conradspiteri-alt/vetus-ec4-decode/hardware/sniffer/enclosure/EC4-Enclosure-Drawing.pdf

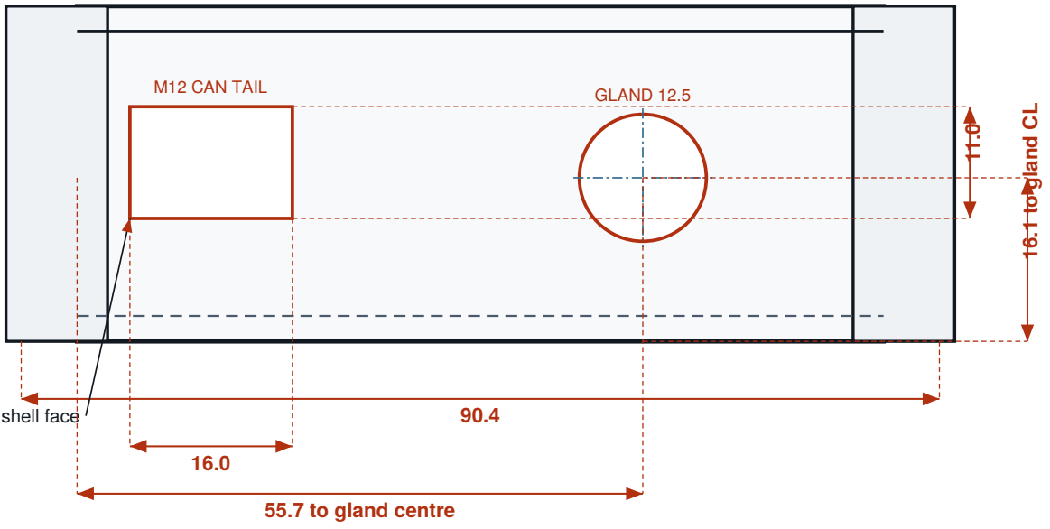
[picture p15: figure]
M12 CAN TAIL; GLAND 12.5; 55.7 to gland centre; 16.1 to gland CL

## EC4 SNIFFER - ENCLOSURE rev B

DWG EC4-200 rev B | NTS | UNITS mm
MATERIAL 3D printed ASA | | WALL / FLOOR / LID 2.5
END VIEW from the connector face | FIXINGS 4 off M3 heat-set insert
DATUM lower-left-front corner | | SEALING none this iteration

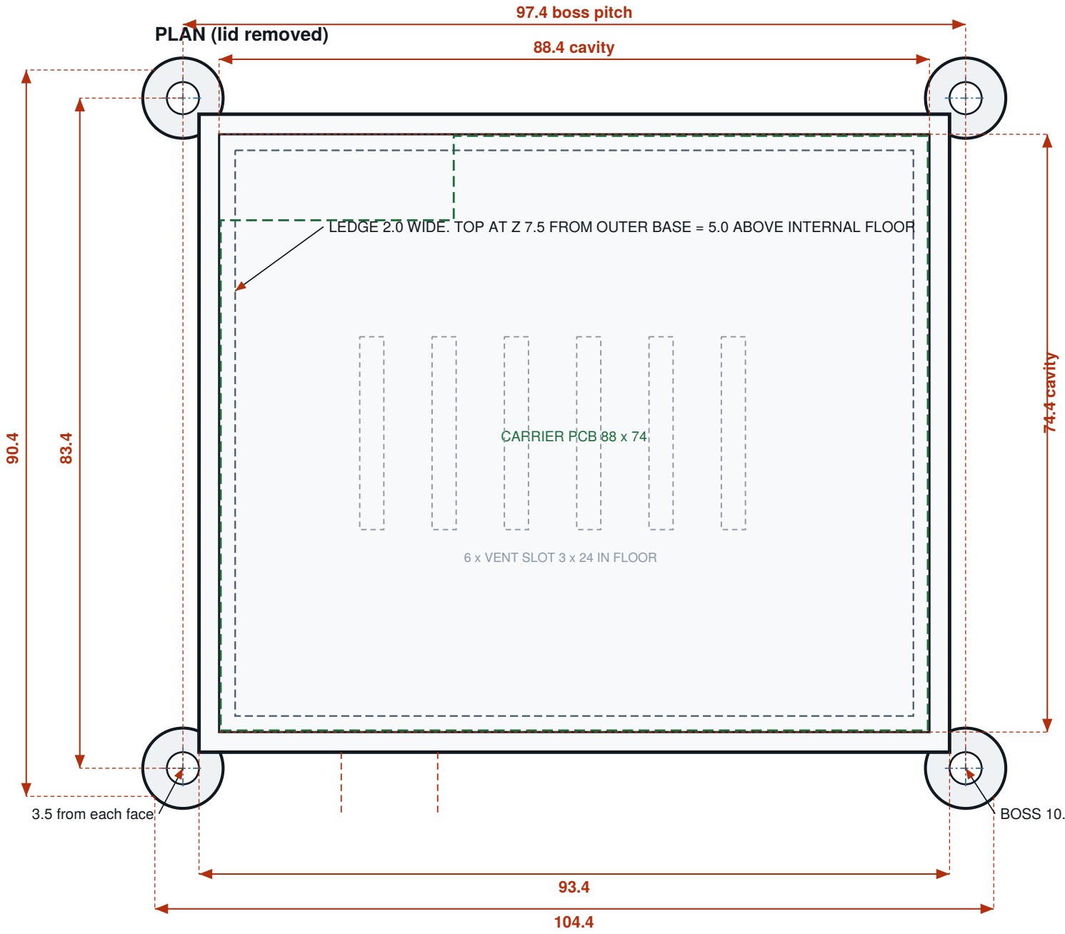
[picture p16: figure]
PLAN (lid removed); CARRIER PCB 88 x 74; 6 x VENT SLOT 3 x 24 IN FLOOR; 97.4 boss pitch; 74.4 cavity; 88.4 cavity

3.5 from each face | BOSS 10.0 O/D, 4.0 INSERT HOLE

LEDGE 2.0 WIDE. TOP AT Z 7.5 FROM OUTER BASE = 5.0 ABOVE INTERNAL FLOOR

## FRONT ELEVATION (port face)

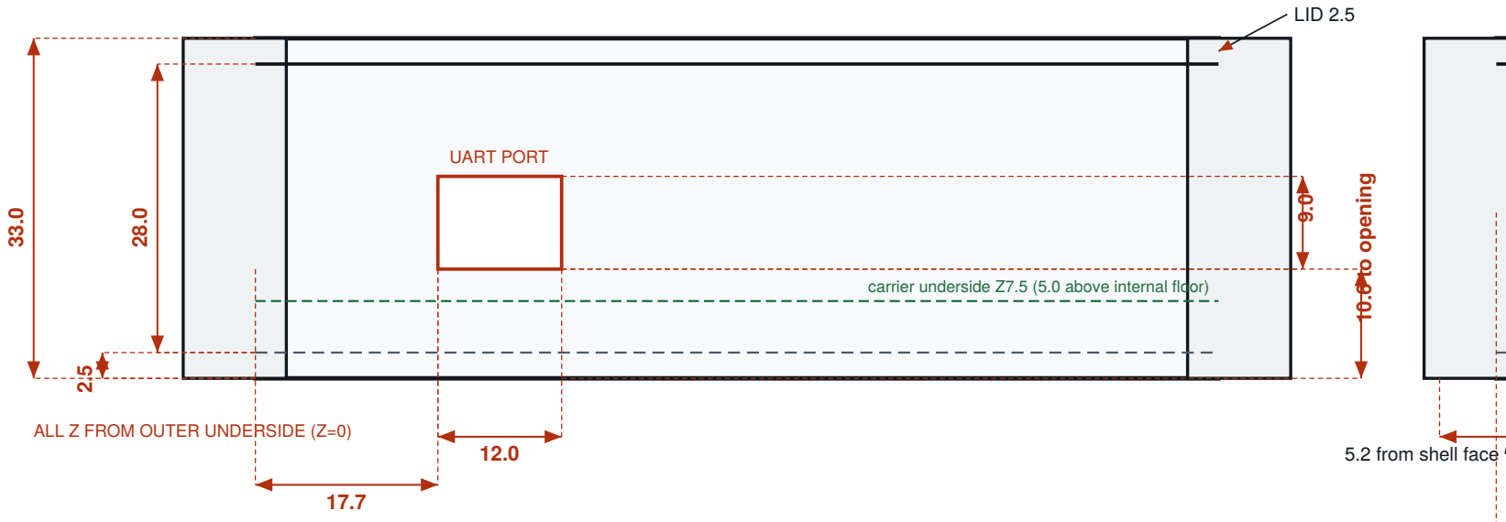
[picture p17: figure]
UART PORT; 10.6 to opening; ALL Z FROM OUTER UNDERSIDE (Z=0); LID 2.5; 5.2 from shell face

carrier underside Z7.5 (5.0 above internal floor)

## END ELEVATION (connector face, viewed from the right)

### HEIGHT DATUMS Z=0 IS THE OUTER UNDERSIDE OF THE BASE

Z FEATURE
2.5 | floor, top face (internal floor)
7.5 | carrier underside, ledge top = 5.0 above floor
9.1 | carrier top face
11.6 | daughterboard underside (2.5 header seat)
13.2 | daughterboard top face
16.4 | DevKitC USB connector top
23.2 | SK Pang DC-DC top
25.7 | DB9 top - the governing height
30.5 | cavity ceiling / lid underside
33.0 | overall top

### NOTES

1. Lid screw bosses are OUTSIDE the cavity by design. Anything inside it fouls the carrier, which fills the cavity.
2. Lid carries a hold-down rib on the carrier's free left edge plus four pads, all stopping 1.5 above the board. Fit 1.5 EVA foam to each -
that foam IS the clamp.
3. Lid: 3.4 clearance with 6.2 counterbore, over 4.0 inserts in the base.
4. LED window 18 x 12 in lid, thinned to 0.6, over the DevKitC RGB LED.
5. Gland replaces the 13 x 10 slot of the earlier model. M12 thread, 12.5 clearance hole, locknut supplied. Cable range 3.0 - 6.5.
6. Headroom above the DB9 is 4.8. Removing the DB9 buys only 2.5, because the DC-DC is next at 23.2.
7. No lid seal and no breather vent this iteration. Sealing without a vent is worse than leaving it unsealed.
