conradspiteri-alt/vetus-ec4-decode/hardware/sniffer/enclosure/EC4-Enclosure-Views.png

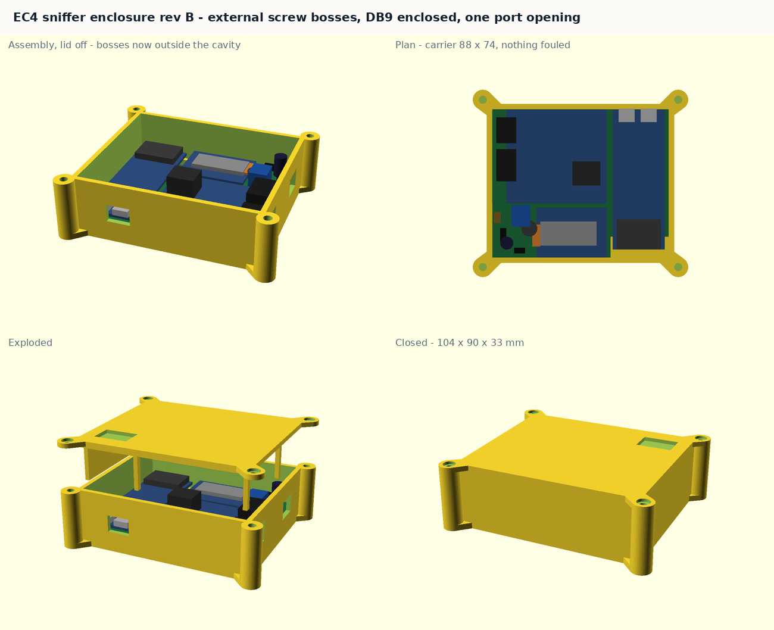
hardware/sniffer/enclosure/EC4-Enclosure-Views.png
