conradspiteri-alt/vetus-ec4-decode/hardware/sniffer/enclosure/EC4-Enclosure-lid.stl

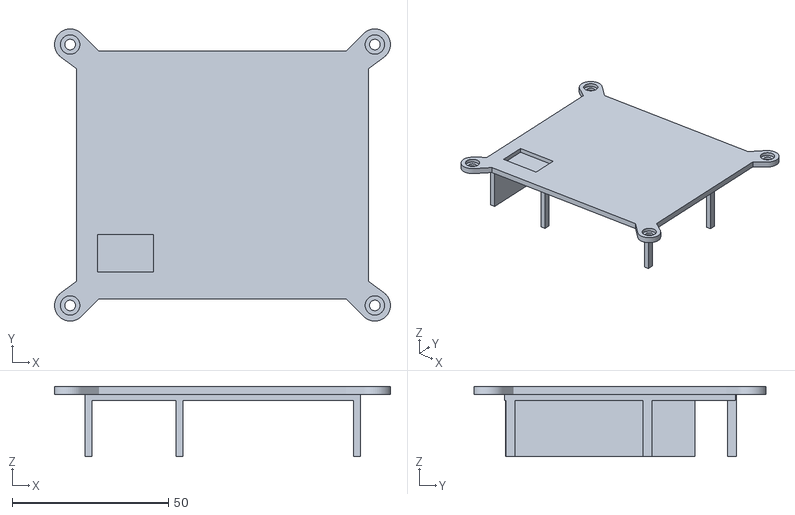
[picture p19: CAD file, 2026-10-06]
hardware/sniffer/enclosure/EC4-Enclosure-lid.stl
107.4 x 93.4 x 22.4
