conradspiteri-alt/vetus-ec4-decode/hardware/sniffer/enclosure/EC4-Enclosure-base.stl

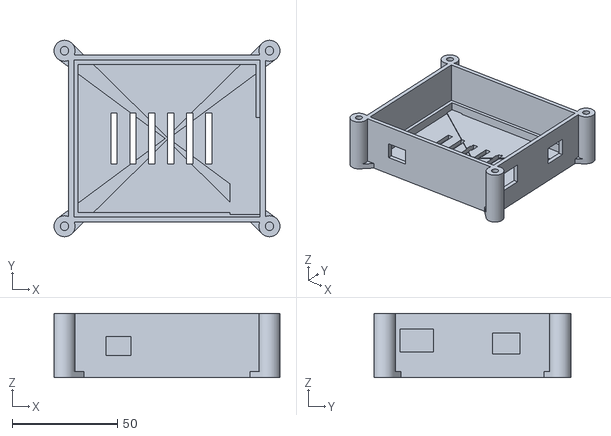
[picture p20: CAD file, 2026-10-06]
hardware/sniffer/enclosure/EC4-Enclosure-base.stl
107.4 x 93.4 x 30.5
