conradspiteri-alt/vetus-ec4-decode/hardware/sniffer/carrier-pcb/kicad-EC4-Carrier/EC4-Carrier.kicad_pcb

## KiCad design hardware/sniffer/carrier-pcb/kicad-EC4-Carrier/EC4-Carrier.kicad_pcb (2026-10-06)

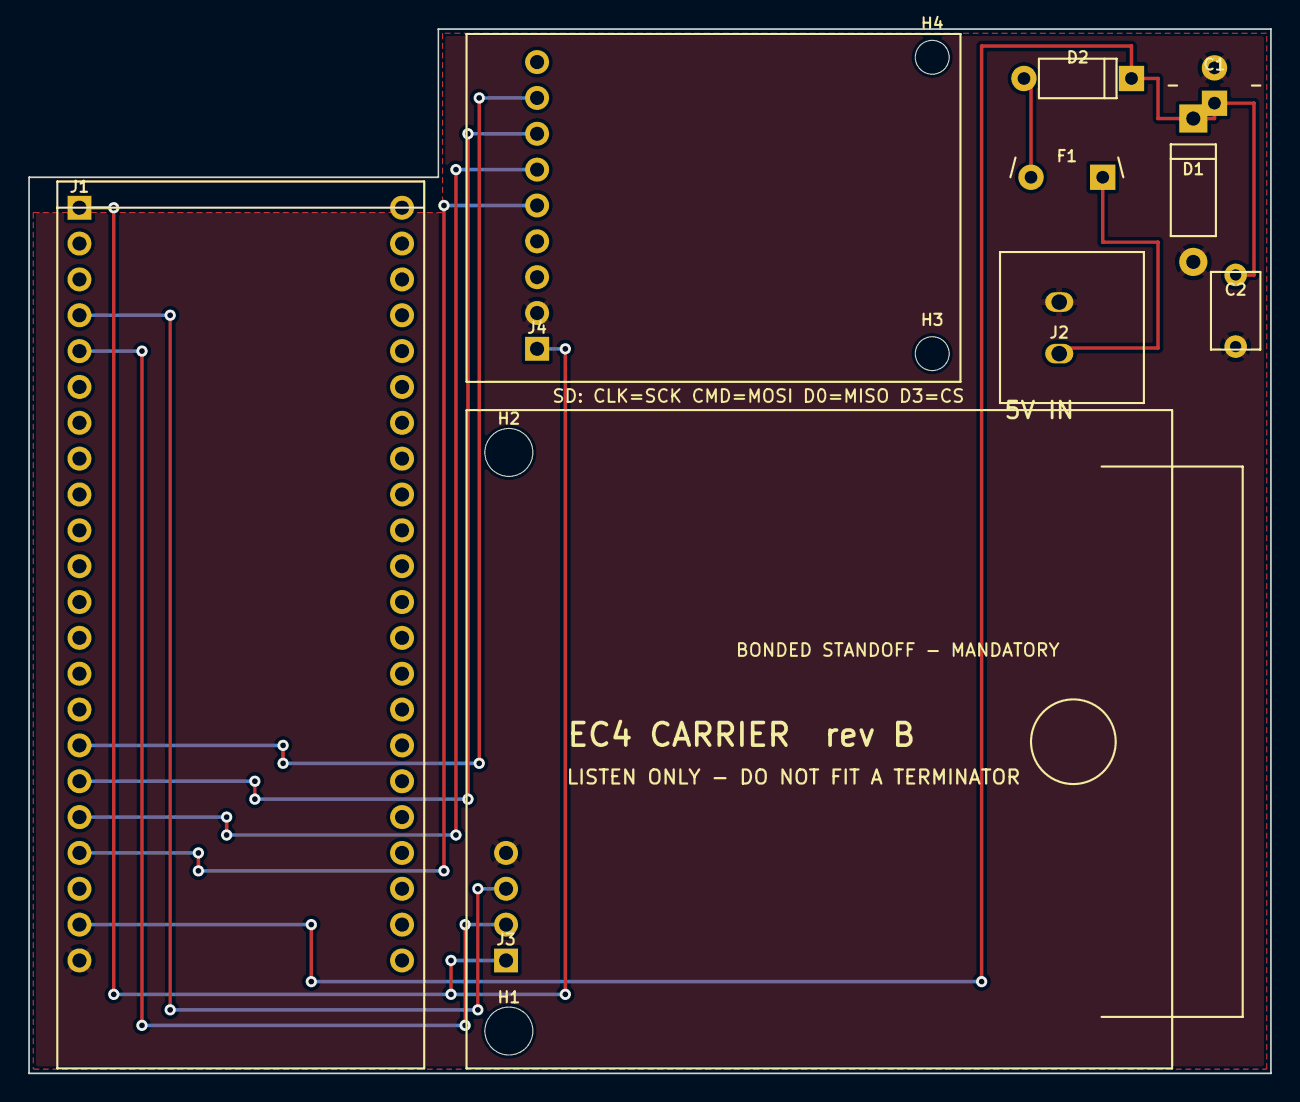
[picture p22: board EC4-Carrier.kicad_pcb from above]

Board: 2 copper layers, 88.0 x 74.0 mm, 13 parts (0 on the bottom side), 11 nets.

Parts:
C1: 100uF-16V-radial-2.5; C1
C2: 100nF-5.08; C2
D1: P6KE6.8A-DO15-10.16; D1
D2: 1N5819-DO41-7.62; D2
F1: PTC-1A-radial-5.08; F1
H1, H2: 3.4mm; MountingHole
H3, H4: 2.4mm; MountingHole
J1: ESP32-S3-DevKitC-1; J1
J2: TerminalBlock_2x3.5mm; J2
J3: SKPang-ISO1050; J3
J4: microSD-SB; J4

Connections:
+3V3: J1.1, J3.1, J4.1
+5V: C1.1, C2.1, D1.2, D2.2, J1.21
CAN_RX: J1.4, J3.3
CAN_TX: J1.5, J3.2
GND: C1.2, C2.2, D1.1, J1.22, J2.2, J3.4, J4.2
SD_CS: J1.16, J4.8
SD_MISO: J1.19, J4.5
SD_MOSI: J1.17, J4.7
SD_SCK: J1.18, J4.6
VF: D2.1, F1.2
VIN: F1.1, J2.1
